gaborsimon/CarDisplay/schematic/CarDisplay.png

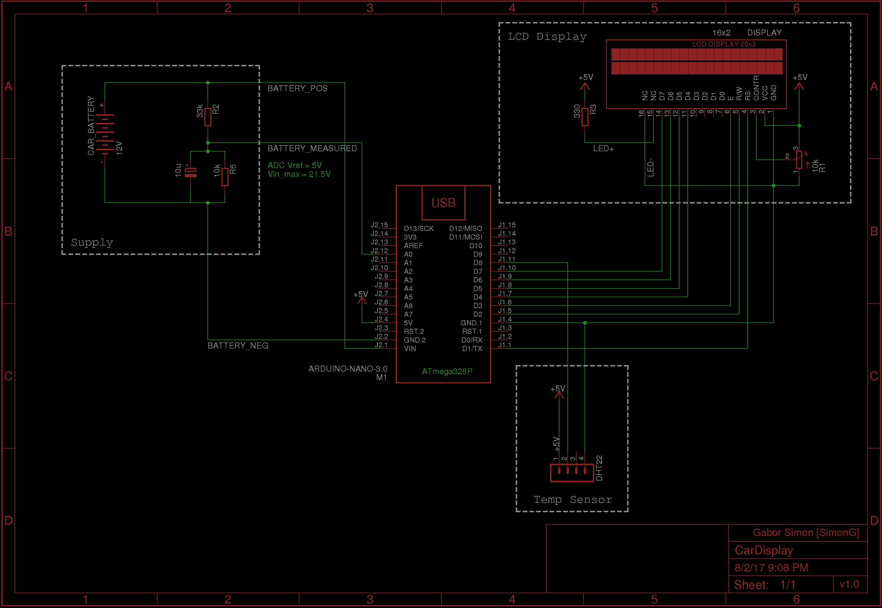
schematic/CarDisplay.png
