gaborsimon/CarDisplay/(threads)

Thread 1 (2017-12-09):

Temperature measurement bug

gaborsimon, 2017-12-09:
The temperature measurement calculation is not correct in the LCDManager.c source file:

line 242:
`LCD_WriteInt((uint8)((XDHT22__TEMPERATURE_VALUE - ((sint8)XDHT22__TEMPERATURE_VALUE)) * 10.0f));`

The negativ value of the fraction is calculated wrongly.
The method has to use the absolute values:
`(uint8)(( absf(XDHT22__TEMPERATURE_VALUE) - (uint8)absf(XDHT22__TEMPERATURE_VALUE) ) * 10.0f)`

Thread 2 (2017-12-09):

HW improvement for high voltage peak

gaborsimon, 2017-12-09:
The main board contains a voltage regulator IC which can be used between 5-20V (max 16V for arduino nano Vin). The car can produce much higher values therefore a 16V zener diode is needed on the main Vin input voltage. Schematic and HW have to be updated.
