gaborsimon/CarDisplay/schematic/CarDisplay.sch

## EAGLE design schematic/CarDisplay.sch (2017-08-02)

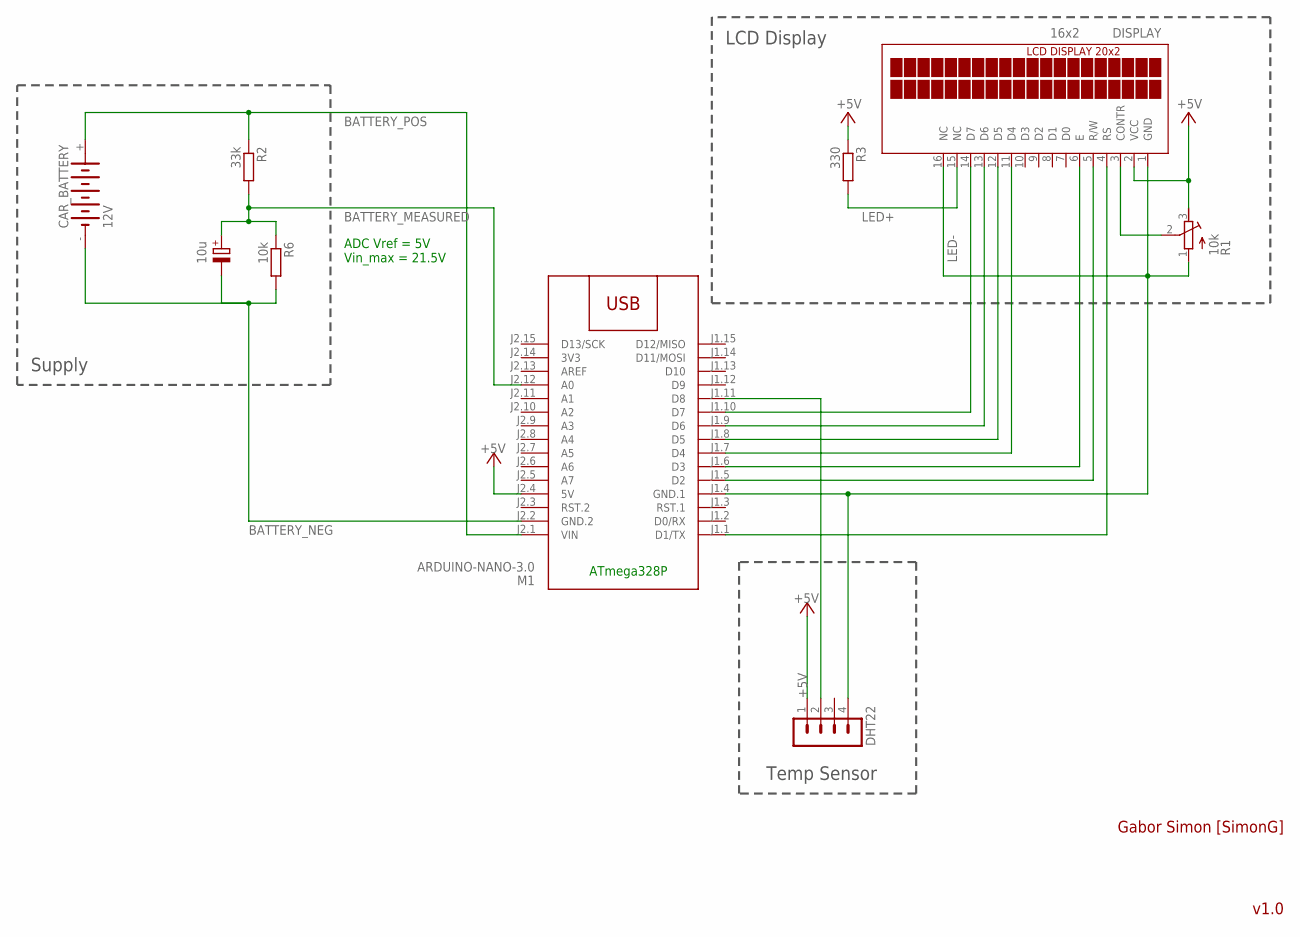
[picture p2: schematic CarDisplay.sch]

Parts:
C4: 10u; E5-8,5
CAR_BATTERY: 12V; 5V280R
DHT22: MA04-1
DISPLAY: 16x2; TUXGR_20X2
M1: ARDUINO-NANO-3.0
R1: 10k; RTRIM3202
R2: 33k; 0204/7
R3: 330; 0204/7
R6: 10k; 0204/7

Connections:
+5V: DHT22.1, DISPLAY.2 (VCC), M1.J2.4 (5V), R1.3 (A), R3.1
BATTERY_MEASURED: C4.+, M1.J2.12 (A0), R2.2, R6.1
BATTERY_NEG: CAR_BATTERY.-, M1.J2.2 (GND.2), R6.2
BATTERY_POS: CAR_BATTERY.+, M1.J2.1 (VIN), R2.1
LED+: DISPLAY.15 (NC), R3.2
LED-: DHT22.4, DISPLAY.1 (GND), DISPLAY.16 (NC), M1.J1.4 (GND.1), R1.1 (E)
unnamed: DISPLAY.6 (E), M1.J1.6 (D3)
unnamed: DISPLAY.5 (R/W), M1.J1.5 (D2)
unnamed: DISPLAY.4 (RS), M1.J1.1 (D1/TX)
unnamed: DISPLAY.14 (D7), M1.J1.10 (D7)
unnamed: DISPLAY.13 (D6), M1.J1.9 (D6)
unnamed: DISPLAY.12 (D5), M1.J1.8 (D5)
unnamed: DISPLAY.11 (D4), M1.J1.7 (D4)
unnamed: DHT22.2, M1.J1.11 (D8)
unnamed: DISPLAY.3 (CONTR), R1.2 (S)

Notes on the sheet:
Gabor Simon [SimonG]
Temp Sensor
Supply
LCD Display
v1.0
ATmega328P
ADC Vref = 5V Vin_max = 21.5V
