gaborsimon/CarDisplay/sources/CarDisplay.c

//====== Header includes =======================================================
#include "CarDisplay.h"


//====== Private Function Prototypes ===========================================
int main(void);


//====== MAIN Function =========================================================
int main(void)
{
    Task_Init();
    Task_Main();

    return 0;
}
