gaborsimon/CarDisplay/(commit log)

2017-07-04 Implemented the main schedulre for tasking. Period time is 1 second. Using the 16-bit Timer1 module in CTC mode with interrupt.
2017-07-19 DHT22 sensor support.
    Minor modifications:
    - New LCD characters due to battery voltage measurement
    - New LCD layout
    - Processor clock is changed to 16MHz -> scheduler timer config change
2017-07-21 Creating version 1.0
    Major modificaitons:
    - LCD Manager module is created to handle the information on the display
    - Watchdog is initialized and used in the application
    - The LCD battery status icon is improved
    - Microcontroller HAL is cleaned
    - Tasking is cleaned
    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
2017-07-23 Bugfix: ADC result calculation is corrected.
    [MicroControllerHAL.c]
2017-07-23 Added schematic to the project
    [CarDisplay.sch]
2017-07-23 Schematic update: the arudino nano component is replaced by better one
    [CarDisplay.sch]
2017-07-25 Minor modification: - Battery Voltage Measurement code part is moved to a separate component - Battery Status icon is improved
2017-07-26 Minor modification: Display "--" in case of not reliable battery voltage signal.
2017-08-02 Finalized elements: - schematic - utility documents - corrected code comments
    [CarDisplay.sch, LCD_design.ods, parameter_calculator.ods]
